samanbeer/LoRa_board/Basket_Oct20_1158AM.xls

SHOPPING BASKET
This is not an invoice
20-Oct-26 12:37:59
 | Mouser No | Mfr. No | Manufacturer | Customer No | Description | RoHS | Lifecycle | Order Qty. | Price (CZK) | Ext.: (CZK)
1 | 611-RS-282G05A3-SMRT | RS-282G05A3-SM RT | C&K Switches |  | Tactile Switches SPST 0.05A 12V 250gf | RoHS Compliant |  | 2 | 17,02 Kč | 34,04 Kč
2 | 81-GCM188R71H104KA7J | GCM188R71H104KA57J | Murata |  | Multilayer Ceramic Capacitors MLCC - SMD/SMT 0.1 uF 50 VDC 10% 0603 X7R AEC-Q200 | RoHS Compliant |  | 6 | 4,26 Kč | 25,56 Kč
3 | 810-C1608X5R1A106K | C1608X5R1A106K080AC | TDK |  | Multilayer Ceramic Capacitors MLCC - SMD/SMT 0603 10V 10uF X5R 10% T: 0.8mm | RoHS Compliant |  | 2 | 9,80 Kč | 19,60 Kč
4 | 187-CL10B474KO8NNNC | CL10B474KO8NNNC | Samsung Electro-Mechanics |  | Multilayer Ceramic Capacitors MLCC - SMD/SMT 470nF+/-10% 16V X7R 0603 | RoHS Compliant |  | 1 | 2,35 Kč | 2,35 Kč
5 | 603-CC603DRNPO9BN8R2 | CC0603DRNPO9BN8R2 | YAGEO |  | Multilayer Ceramic Capacitors MLCC - SMD/SMT 50 V 8.2pF C0G 0603 Tol 0.5pF | RoHS Compliant |  | 1 | 2,13 Kč | 2,13 Kč
6 | 603-CC603DRNPO9BN5R6 | CC0603DRNPO9BN5R6 | YAGEO |  | Multilayer Ceramic Capacitors MLCC - SMD/SMT 50 V 5.6pF C0G 0603 Tol 0.5pF | RoHS Compliant |  | 1 | 2,13 Kč | 2,13 Kč
7 | 810-C1608X5R1C475KAC | C1608X5R1C475K080AC | TDK |  | Multilayer Ceramic Capacitors MLCC - SMD/SMT 0603 16V 4.7uF X5R 10% T: 0.8mm | RoHS Compliant |  | 2 | 5,32 Kč | 10,64 Kč
8 | 80-C0603C105K4RAC | C0603C105K4RAC | KEMET |  | Multilayer Ceramic Capacitors MLCC - SMD/SMT 16V 1uF X7R 0603 10% | RoHS Compliant |  | 1 | 2,97 Kč | 2,97 Kč
9 | 603-CC603JPNPO9BN470 | CC0603JPNPO9BN470 | YAGEO |  | Multilayer Ceramic Capacitors MLCC - SMD/SMT 50 V 47 pF C0G 0603 5% | RoHS Compliant |  | 2 | 2,13 Kč | 4,26 Kč
10 | 187-CL10B102KB8NNNC | CL10B102KB8NNNC | Samsung Electro-Mechanics |  | Multilayer Ceramic Capacitors MLCC - SMD/SMT 1nF+/-10% 50V X7R 16 0603 | RoHS Compliant |  | 1 | 2,13 Kč | 2,13 Kč
11 | 81-GRM39C101J50 | GRM1885C1H101JA01D | Murata |  | Multilayer Ceramic Capacitors MLCC - SMD/SMT 100 pF 50 VDC 5% 0603 C0G (NP0) | RoHS Compliant | NRND | 1 | 2,35 Kč | 2,35 Kč
12 | 187-CL10C1R8BB8NNNC | CL10C1R8BB8NNNC | Samsung Electro-Mechanics |  | Multilayer Ceramic Capacitors MLCC - SMD/SMT 1.8pF+/-0.1pF 50V C0 0603 | RoHS Compliant |  | 1 | 2,13 Kč | 2,13 Kč
13 | 81-GRM1885C1H2R2BA1D | GRM1885C1H2R2BA01D | Murata |  | Multilayer Ceramic Capacitors MLCC - SMD/SMT 2.2 pF 50 VDC 0.1 pF 0603 C0G (NP0) | RoHS Compliant | NRND | 1 | 2,97 Kč | 2,97 Kč
14 | 656-DX07S016JA1R1500 | DX07S016JA1R1500 | JAE Electronics |  | USB Connectors USB Type C Rcptcl 16-Pin SMT | RoHS Compliant |  | 1 | 37,36 Kč | 37,36 Kč
15 | 798-UFLRSMT160 | U.FL-R-SMT-1(60) | Hirose Electric |  | RF Connectors / Coaxial Connectors SMT MALE RECEPT AU | RoHS Compliant |  | 1 | 32,90 Kč | 32,90 Kč
16 | 81-LQM18DH150M70L | LQM18DH150M70L | Murata |  | Power Inductors - SMD 0603 15uH 20% 220mA 2.54ohm AEC-Q200 | RoHS Compliant |  | 1 | 6,38 Kč | 6,38 Kč
17 | 81-LQW18AN12NG00D | LQW18AN12NG00D | Murata |  | RF Inductors - SMD 12 NH 2% | RoHS Compliant |  | 1 | 2,77 Kč | 2,77 Kč
18 | 81-LQW18AN5N6C0ZD | LQW18AN5N6C0ZD | Murata |  | RF Inductors - SMD | RoHS Compliant |  | 1 | 3,19 Kč | 3,19 Kč
19 | 81-LQW18AS6N8J0ZD | LQW18AS6N8J0ZD | Murata |  | RF Inductors - SMD | RoHS Compliant |  | 1 | 3,19 Kč | 3,19 Kč
20 | 603-RC0603FR-135K1L | RC0603FR-135K1L | YAGEO |  | Thick Film Resistors - SMD General Purpose Chip Resistor 0603, 5.1kOhms, 1%, 1/10W | RoHS Compliant By Exemption |  | 2 | 2,13 Kč | 4,26 Kč
21 | 603-RC0603FR-0710KL | RC0603FR-0710KL | YAGEO |  | Thick Film Resistors - SMD General Purpose Chip Resistor 0603, 10kOhms, 1%, 1/10W | RoHS Compliant By Exemption |  | 2 | 2,13 Kč | 4,26 Kč
22 | 603-RC0603FR-07100RL | RC0603FR-07100RL | YAGEO |  | Thick Film Resistors - SMD General Purpose Chip Resistor 0603, 100Ohms, 1%, 1/10W | RoHS Compliant By Exemption |  | 2 | 2,13 Kč | 4,26 Kč
23 | 855-M20-9994045 | M20-9994045 | Harwin |  | Headers & Wire Housings M20 40 SIL HORIZONTAL PIN HEADER TIN | RoHS Compliant |  | 1 | 41,07 Kč | 41,07 Kč
24 | 356-ESP32-S3WROOM1N8 | ESP32-S3-WROOM-1-N8 | Espressif |  | Multiprotocol Modules SMD module, ESP32-S3, 8 MB SPI flash, PCB antenna | RoHS Compliant |  | 1 | 120,48 Kč | 120,48 Kč
25 | 81-PE42359SCAA-Z | PE42359SCAA-Z | pSemi |  | RF Switch ICs AEC-Q100 Certified SPDT, Low IL, Reflective, 50ohm RF Switch | RoHS Compliant |  | 1 | 20,86 Kč | 20,86 Kč
26 | 947-SX1262IMLTRT | SX1262IMLTRT | Semtech |  | RF Transceiver LoRa, sub-GHz RF Transceiver 22dBm PA | RoHS Compliant |  | 1 | 192,23 Kč | 192,23 Kč
27 | 621-AP2112K-3.3TRG1 | AP2112K-3.3TRG1 | Diodes Incorporated |  | LDO Voltage Regulators 600mA CMOS LDO 50mA 3.3V 250mV | RoHS Compliant |  | 1 | 5,74 Kč | 5,74 Kč
28 | 815-M832000MHZ10B1UT | ABM8-32.000MHZ-10-B1U-T | ABRACON |  | Crystals Xtal 3225 4-SMD 32MHz Tol 10ppm Stab 10ppm -20 C - 70 C 10pF 40 Ohms | RoHS Compliant |  | 1 | 10,42 Kč | 10,42 Kč
29 | 81-LQW18AN47NG00D | LQW18AN47NG00D | Murata |  | RF Inductors - SMD 47 NH 2% | RoHS Compliant |  | 1 | 2,77 Kč | 2,77 Kč
By submitting your order you agree to these terms and conditions. (https://cz.mouser.com/saleterms) |  |  |  |  |  |  |  |  | Merchandise: | 605,40 Kč
Prices are reflected at the date and time shown. |  |  |  |  |  |  |  |  | Delivery Charge: | 600,00 Kč
 |  |  |  |  |  |  |  |  | Back-order Delivery: | 0,00 Kč
