samanbeer/LoRa_board/PCB/LoRa_Board.csv

Reference | Qty | Value | Footprint | Datasheet
BOOT1,RESET1 | 2 | SW_Push | Button_Switch_SMD:SW_SPST_CK_RS282G05A3
C1,C4,C5,C10,C13,C18 | 6 | 100nF | Capacitor_SMD:C_0603_1608Metric
C2 | 1 | 10µF | Capacitor_SMD:C_0603_1608Metric
C3 | 1 | 470nF | Capacitor_SMD:C_0603_1608Metric
C6 | 1 | 8.2pF | Capacitor_SMD:C_0603_1608Metric
C7 | 1 | 5.6pF | Capacitor_SMD:C_0603_1608Metric
C8,C9 | 2 | 4,7uF | Capacitor_SMD:C_0603_1608Metric
C11 | 1 | 1uF | Capacitor_SMD:C_0603_1608Metric
C12 | 1 | 10uF | Capacitor_SMD:C_0603_1608Metric
C14,C15 | 2 | 47pF | Capacitor_SMD:C_0603_1608Metric
C16 | 1 | 1nF | Capacitor_SMD:C_0603_1608Metric
C17 | 1 | 100pF | Capacitor_SMD:C_0603_1608Metric
C19 | 1 | 1.8pF | Capacitor_SMD:C_0603_1608Metric
C20 | 1 | 2.2pF | Capacitor_SMD:C_0603_1608Metric
J1 | 1 | USB_C_Receptacle_USB2.0_14P | Connector_USB:USB_C_Receptacle_JAE_DX07S016JA1R1500 | https://www.usb.org/sites/default/files/documents/usb_type-c.zip
J2 | 1 | Conn_Coaxial | Connector_Coaxial:U.FL_Hirose_U.FL-R-SMT-1_Vertical
L1 | 1 | 15µH | Inductor_SMD:L_0603_1608Metric
L2 | 1 | 12nH | Inductor_SMD:L_0603_1608Metric
L3 | 1 | 47nH | Inductor_SMD:L_0603_1608Metric
L4 | 1 | 5,6nH | Inductor_SMD:L_0603_1608Metric
L5 | 1 | 6.8nH | Inductor_SMD:L_0603_1608Metric
R1,R2 | 2 | R5.1k | Resistor_SMD:R_0603_1608Metric
R3,R4 | 2 | 10k | Resistor_SMD:R_0603_1608Metric
R5 | 1 | R100 | Resistor_SMD:R_0603_1608Metric
TP1 | 1 | TX0 | Connector_PinHeader_2.54mm:PinHeader_1x01_P2.54mm_Vertical
TP2 | 1 | RX0 | Connector_PinHeader_2.54mm:PinHeader_1x01_P2.54mm_Vertical
U1 | 1 | ESP32-S3-WROOM-1 | RF_Module:ESP32-S3-WROOM-1 | https://www.espressif.com/sites/default/files/documentation/esp32-s3-wroom-1_wroom-1u_datasheet_en.pdf
U2 | 1 | PE4259 | Package_TO_SOT_SMD:SOT-363_SC-70-6 | https://lcsc.com/datasheet/lcsc_datasheet_2409301504_pSemi-PE4259-63_C470892.pdf
U3 | 1 | SX1262IMLTRT | Package_DFN_QFN:QFN-24-1EP_4x4mm_P0.5mm_EP2.6x2.6mm | https://semtech.file.force.com/sfc/dist/version/download/?oid=00DE0000000JelG&ids=0682R00000IjPWSQA3
U4 | 1 | AP2112K-3.3 | Package_TO_SOT_SMD:SOT-23-5_HandSoldering | https://www.diodes.com/assets/Datasheets/AP2112.pdf
Y1 | 1 | 32MHz | Crystal:Crystal_SMD_3225-4Pin_3.2x2.5mm
