samanbeer/LoRa_board/CAD/LoRA_BoardCase_FULL_ASSEMBLY.step

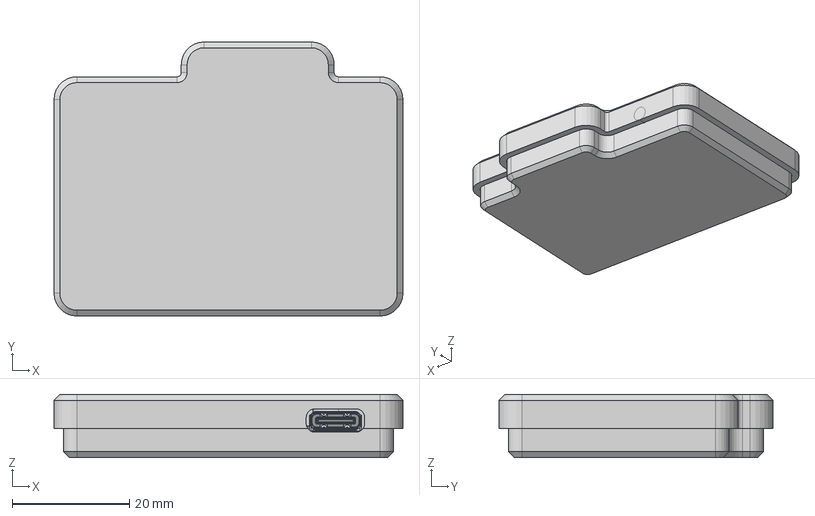
[picture p14: CAD file, 2026-10-28]
CAD/LoRA_BoardCase_FULL_ASSEMBLY.step
59.7 x 46.9 x 10.8 mm
QFN-24-1EP_4x4mm_Pitch0.5mm
C_0603_1608Metric_1 x 20
R_0603_1608Metric_1 x 5
U.FL_Hirose_U.FL-R-SMT-1_Vertical_1
SOT-363_SC-70-6_1
L_0603_1608Metric_1 x 5
ESP32-S3-WROOM-1_1
USB4105GFA_USB4105GFA
SW_SPST_CK_RS282G05A3_1 x 2
Crystal_SMD_3225-4Pin_3.2x2.5mm_1
SOT-23-5_1
LoRa_Board_silkscreen
LoRa_Board_PCB
