samanbeer/LoRa_board/CAD/LoRA_BoardCase_BOTTOM.step

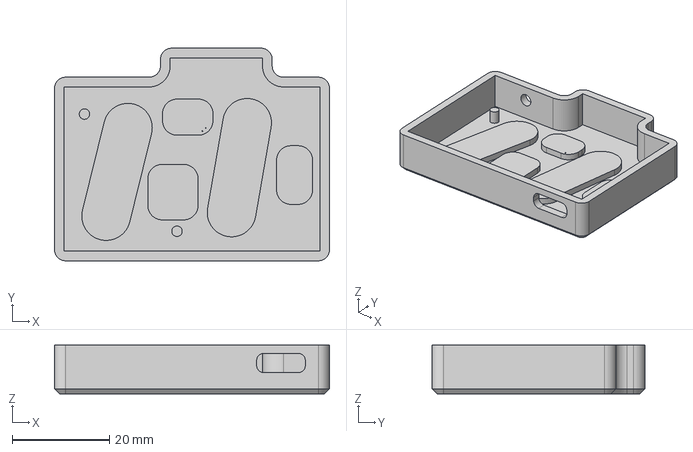
[picture p15: CAD file, 2026-10-28]
CAD/LoRA_BoardCase_BOTTOM.step
56.5 x 43.7 x 10.0 mm
