samanbeer/LoRa_board/CAD/LoRA_BoardCase_LID.step

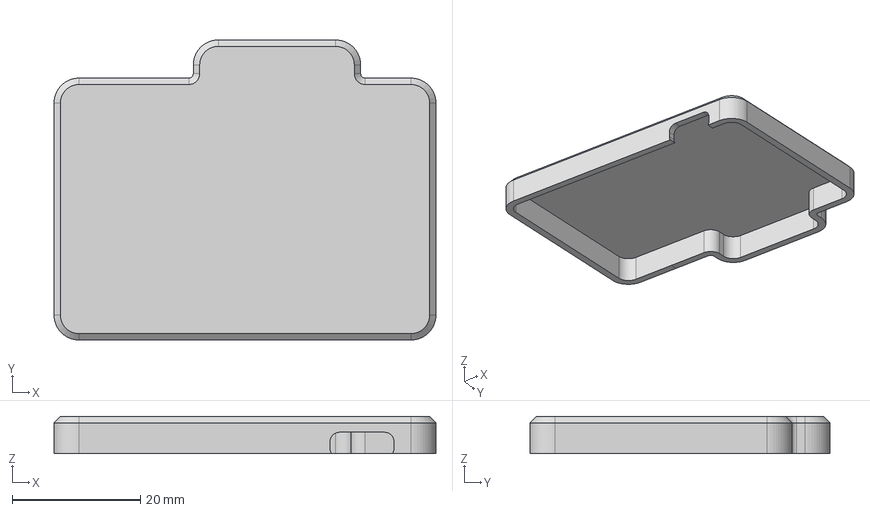
[picture p16: CAD file, 2026-10-28]
CAD/LoRA_BoardCase_LID.step
59.7 x 46.9 x 5.80 mm
