samanbeer/LoRa_board/CAD/KiCAD_PCB_export.step

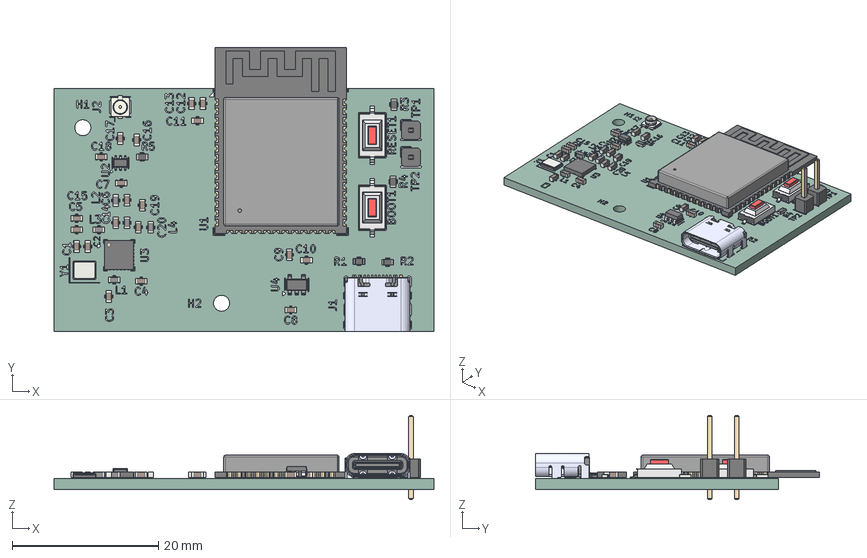
[picture p17: CAD file, 2026-10-28]
CAD/KiCAD_PCB_export.step
52.1 x 38.9 x 11.5 mm
QFN-24-1EP_4x4mm_Pitch0.5mm
C_0603_1608Metric x 20
R_0603_1608Metric x 5
PinHeader_1x01_P254mm_Vertical x 2
U.FL_Hirose_U.FL-R-SMT-1_Vertical
SOT-363_SC-70-6
L_0603_1608Metric x 5
ESP32-S3-WROOM-1
USB4105GFA_USB4105GFA
SW_SPST_CK_RS282G05A3 x 2
Crystal_SMD_3225-4Pin_3.2x2.5mm
SOT-23-5
LoRa_Board_silkscreen
LoRa_Board_PCB
