samanbeer/LoRa_board/(list of files, cad)

Other CAD files:
CAD/LoRA_BoardCase_FUSION_PROJECT.f3z
