samanbeer/LoRa_board/PCB/LoRa_Board.kicad_pcb

## KiCad design PCB/LoRa_Board.kicad_pcb (2026-10-28)

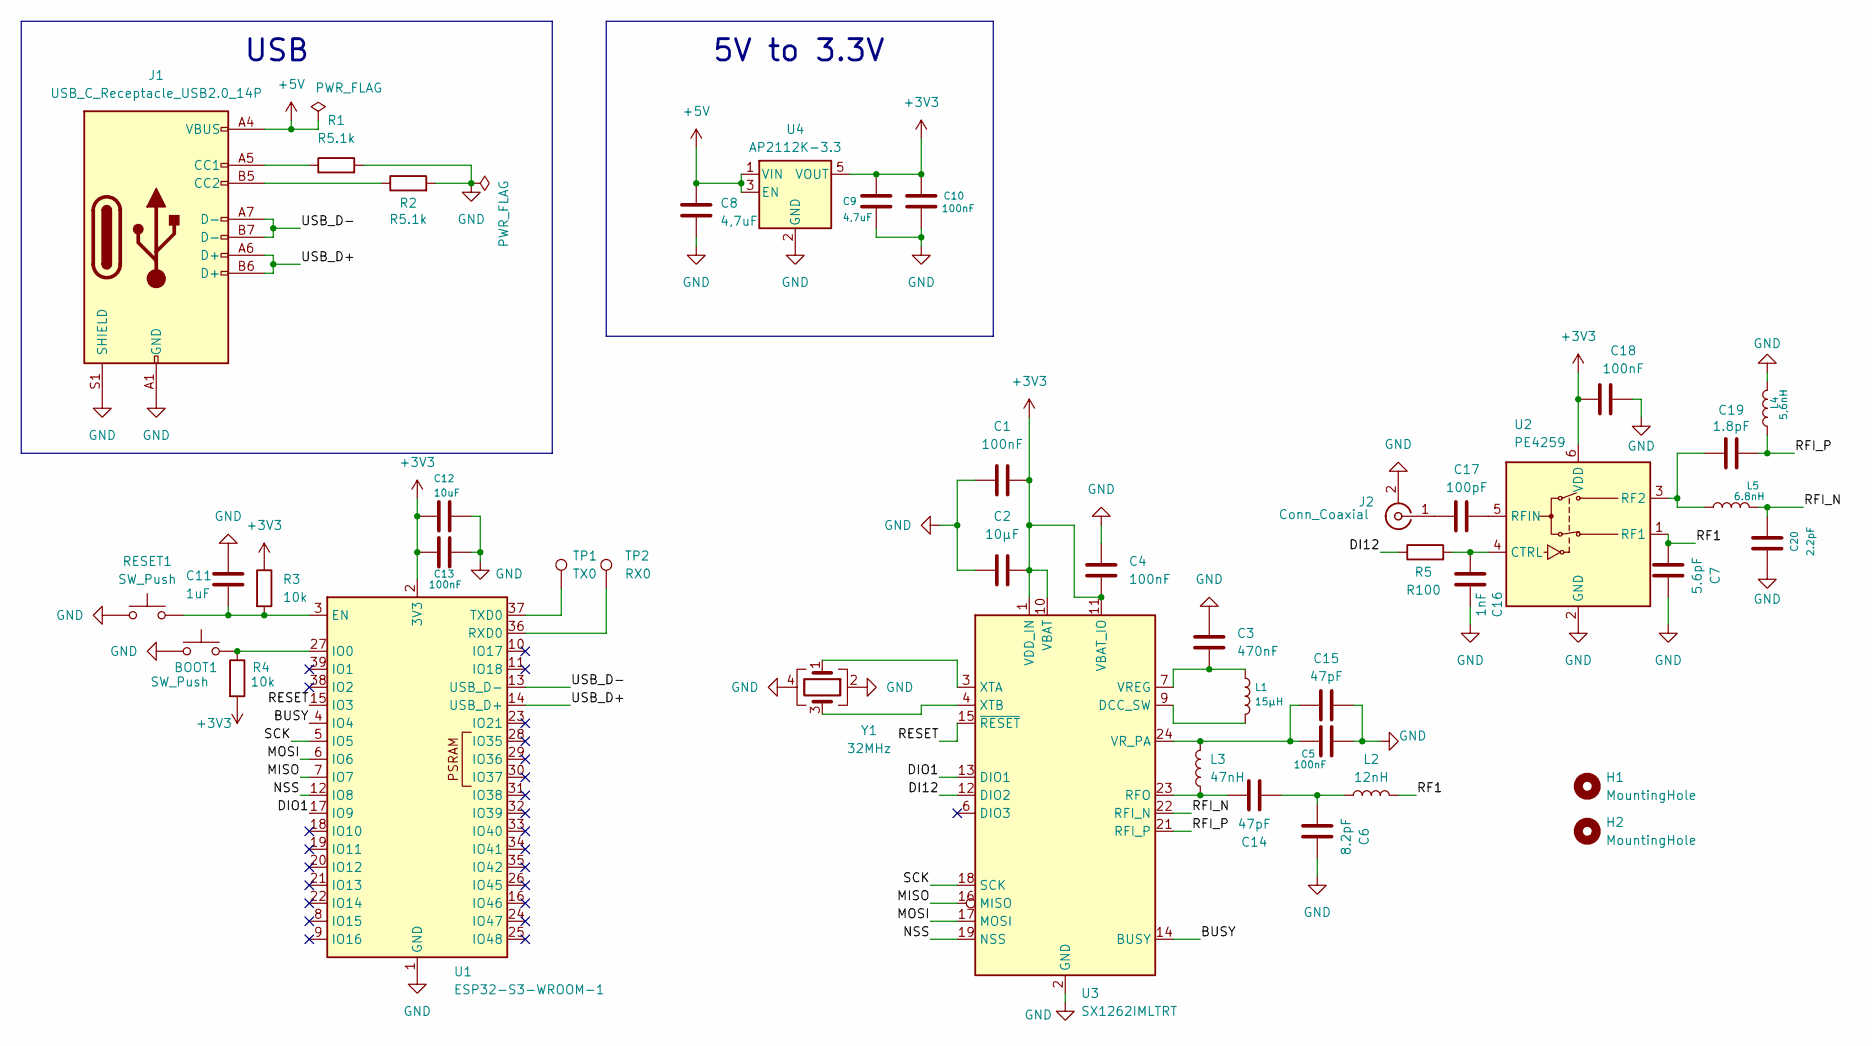
[picture p18: schematic LoRa_Board.kicad_sch]

Parts:
BOOT1: SW_Push; SW_SPST_CK_RS282G05A3
C1, C4, C5, C10, C13, C18: 100nF; C_0603_1608Metric
C2: 10µF; C_0603_1608Metric
C3: 470nF; C_0603_1608Metric
C6: 8.2pF; C_0603_1608Metric
C7: 5.6pF; C_0603_1608Metric
C8, C9: 4,7uF; C_0603_1608Metric
C11: 1uF; C_0603_1608Metric
C12: 10uF; C_0603_1608Metric
C14, C15: 47pF; C_0603_1608Metric
C16: 1nF; C_0603_1608Metric
C17: 100pF; C_0603_1608Metric
C19: 1.8pF; C_0603_1608Metric
C20: 2.2pF; C_0603_1608Metric
H1, H2: MountingHole; MountingHole_2.2mm_M2_Pad
J1: USB_C_Receptacle_USB2.0_14P; USB_C_Receptacle_JAE_DX07S016JA1R1500
J2: Conn_Coaxial; U.FL_Hirose_U.FL-R-SMT-1_Vertical
L1: 15µH; L_0603_1608Metric
L2: 12nH; L_0603_1608Metric
L3: 47nH; L_0603_1608Metric
L4: 5,6nH; L_0603_1608Metric
L5: 6.8nH; L_0603_1608Metric
R1, R2: R5.1k; R_0603_1608Metric
R3, R4: 10k; R_0603_1608Metric
R5: R100; R_0603_1608Metric
RESET1: SW_Push; SW_SPST_CK_RS282G05A3
TP1: TX0; PinHeader_1x01_P2.54mm_Vertical
TP2: RX0; PinHeader_1x01_P2.54mm_Vertical
U1: ESP32-S3-WROOM-1
U2: PE4259; SOT-363_SC-70-6
U3: SX1262IMLTRT; QFN-24-1EP_4x4mm_P0.5mm_EP2.6x2.6mm
U4: AP2112K-3.3; SOT-23-5_HandSoldering
Y1: 32MHz; Crystal_SMD_3225-4Pin_3.2x2.5mm

Connections:
+3V3: C1.1, C2.2, C4.2, C9.1, C10.1, C12.1, C13.1, C18.2, R3.1, R4.2, U1.2 (3V3), U2.6 (VDD), U3.1 (VDD_IN), U3.10 (VBAT), U3.11 (VBAT_IO), U4.5 (VOUT)
+5V: C8.1, J1.A4 (VBUS), J1.A9 (VBUS), J1.B4 (VBUS), J1.B9 (VBUS), U4.1 (VIN), U4.3 (EN)
/BUSY: U1.4 (IO4), U3.14 (BUSY)
/DI12: R5.1, U3.12 (DIO2)
/DIO1: U1.17 (IO9), U3.13 (DIO1)
/MISO: U1.7 (IO7), U3.16 (MISO)
/MOSI: U1.6 (IO6), U3.17 (MOSI)
/NSS: U1.12 (IO8), U3.19 (NSS)
/RESET: U1.15 (IO3), U3.15 (~RESET)
/RF1: C7.1, L2.2, U2.1 (RF1)
/RFI_N: C20.2, L5.2, U3.22 (RFI_N)
/RFI_P: C19.2, L4.1, U3.21 (RFI_P)
/SCK: U1.5 (IO5), U3.18 (SCK)
/USB_D+: J1.A6 (D+), J1.B6 (D+), U1.14 (USB_D+)
/USB_D-: J1.A7 (D-), J1.B7 (D-), U1.13 (USB_D-)
GND: BOOT1.1, C1.2, C2.1, C3.1, C4.1, C5.2, C6.2, C7.2, C8.2, C9.2, C10.2, C11.1, C12.2, C13.2, C15.2, C16.2, C18.1, C20.1, J1.A1 (GND), J1.A12 (GND), J1.B1 (GND), J1.B12 (GND), J1.S1 (SHIELD), J2.2 (Ext), L4.2, R1.2, R2.2, RESET1.1, U1.1 (GND), U1.40 (GND), U1.41 (GND), U2.2 (GND), U3.2 (GND), U3.5 (GND), U3.8 (GND), U3.20 (GND), U3.25 (GND), U4.2 (GND), Y1.2, Y1.4
unnamed: C6.1, C14.1, L2.1
unnamed: J1.A5 (CC1), R1.1
unnamed: J1.B5 (CC2), R2.1
unnamed: C17.1, J2.1 (In)
unnamed: C11.2, R3.2, RESET1.2, U1.3 (EN)
unnamed: BOOT1.2, R4.1, U1.27 (IO0)
unnamed: TP2.1 (1_1), U1.36 (RXD0)
unnamed: TP1.1 (1_1), U1.37 (TXD0)
unnamed: C16.1, R5.2, U2.4 (CTRL)
unnamed: C19.1, L5.1, U2.3 (RF2)
unnamed: C17.2, U2.5 (RFIN)
unnamed: L1.2, U3.9 (DCC_SW)
unnamed: C14.2, L3.1, U3.23 (RFO)
unnamed: C3.2, L1.1, U3.7 (VREG)
unnamed: C5.1, C15.1, L3.2, U3.24 (VR_PA)
unnamed: U3.3 (XTA), Y1.1
unnamed: U3.4 (XTB), Y1.3

Notes on the sheet:
USB
5V to 3.3V

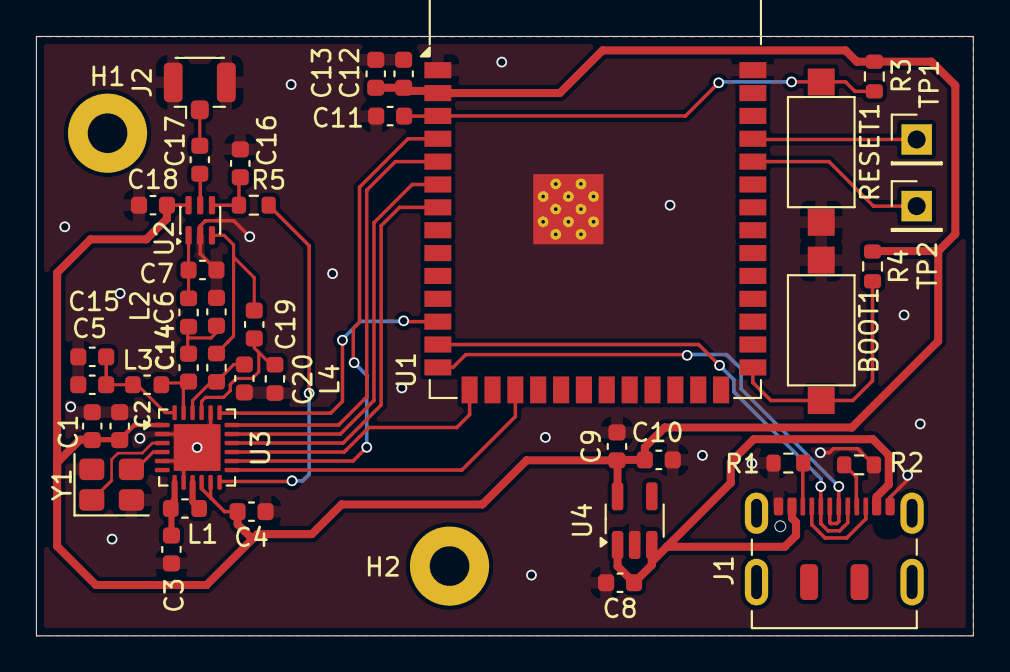
[picture p19: board LoRa_Board.kicad_pcb from above]

Board: 2 copper layers, 52.1 x 33.3 mm, 43 parts (0 on the bottom side), 33 nets.
