samanbeer/LoRa_board/(commit log)

2026-10-14 schematic done
    [LoRa_Board.csv, LoRa_Board.kicad_pcb, LoRa_Board.kicad_sch]
2026-10-21 added BOM (2 hours)
    [Basket_Oct20_1158AM.xls, LoRa_Board.kicad_sch]
2026-10-28 Exported 3d model of CAD + gerbers
    [KiCAD_PCB.step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]
2026-10-28 CAD done :)
    [LoRA_BoardCase_BOTTOM.step, LoRA_BoardCase_FULL_ASSEMBLY.step, LoRA_BoardCase_FUSION_PROJECT.f3z, LoRA_BoardCase_LID.step]
